SemicolonExpected/Brobot/README.txt

TTree goes into the library.

Thanks for reading.
