SemicolonExpected/Brobot/Brobot-Assem.pdf

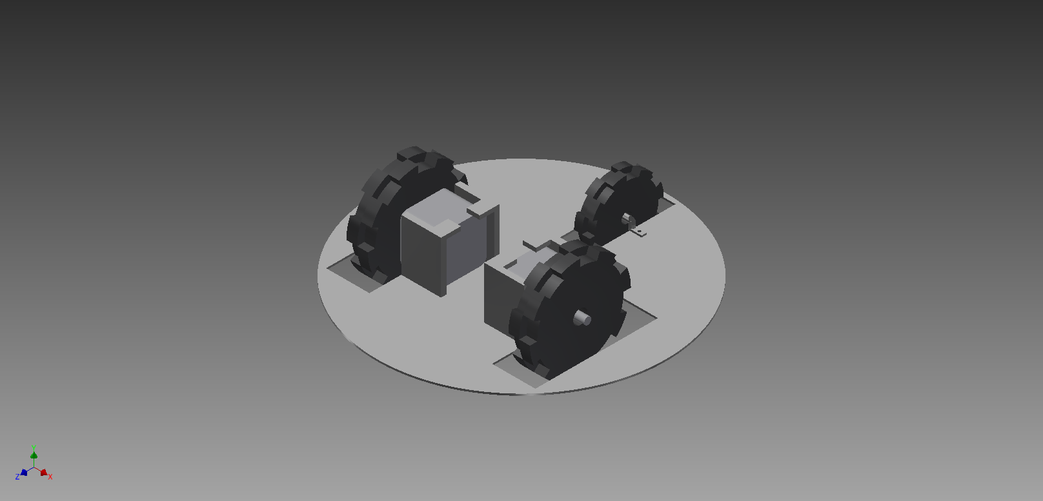
[picture p1: page 1]
