SemicolonExpected/Brobot/Brobot_schem.png

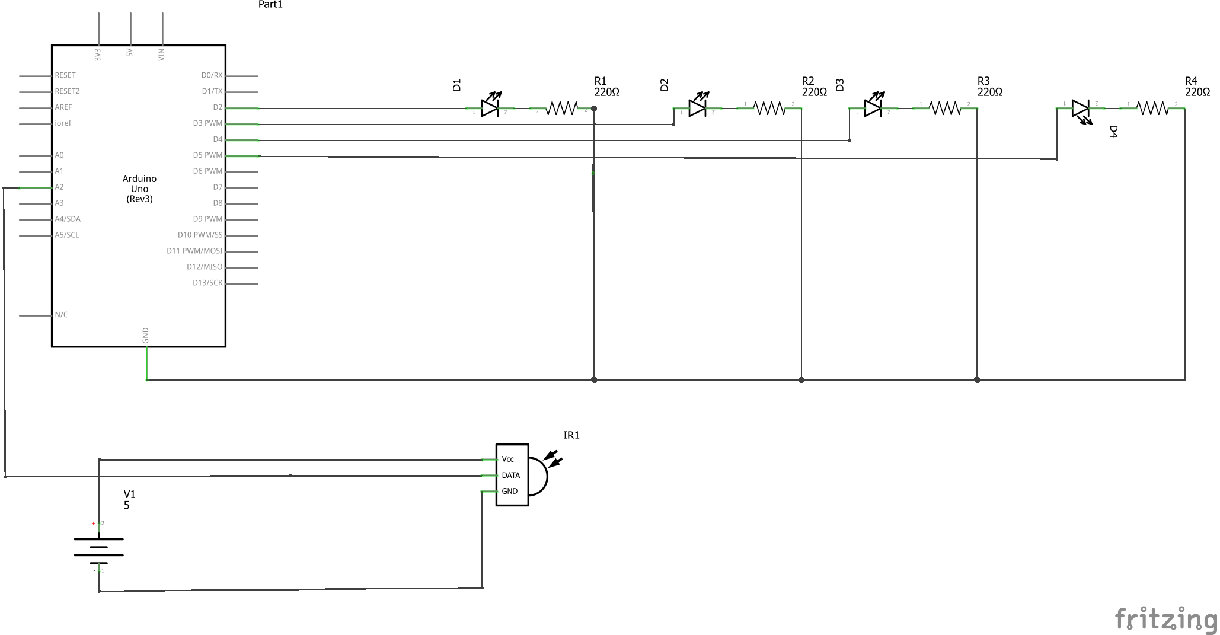
Brobot_schem.png
