SemicolonExpected/Brobot/WheelThing.pdf

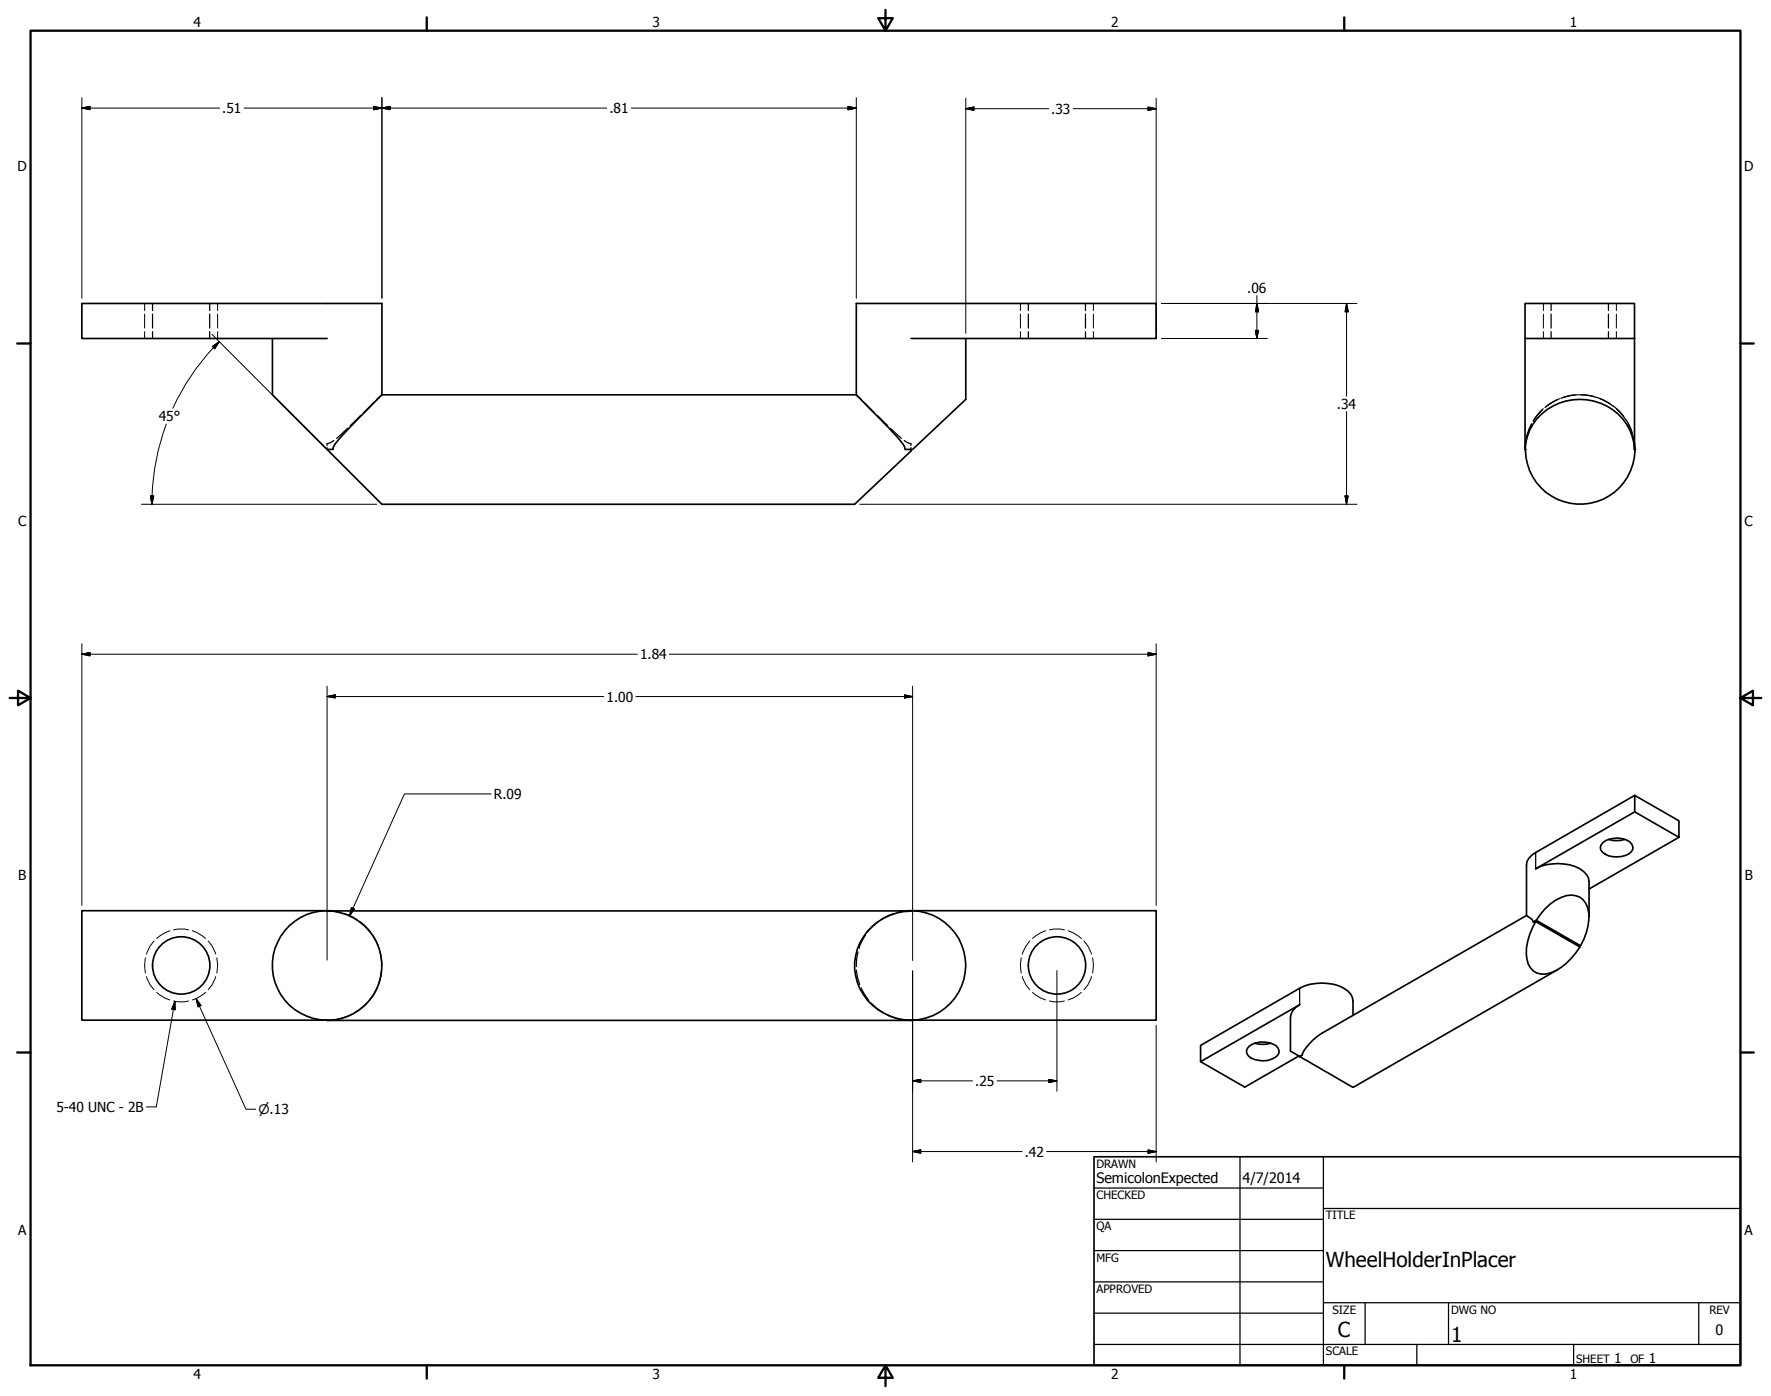
[picture p3: page 1]
SHEET 1 OF 1; DRAWN; CHECKED; MFG; APPROVED; SemicolonExpected; DWG NO 1; TITLE; WheelHolderInPlacer; SIZE C; SCALE; REV 0; 5-40 UNC - 2B
