SemicolonExpected/Brobot/Brobot.pdf

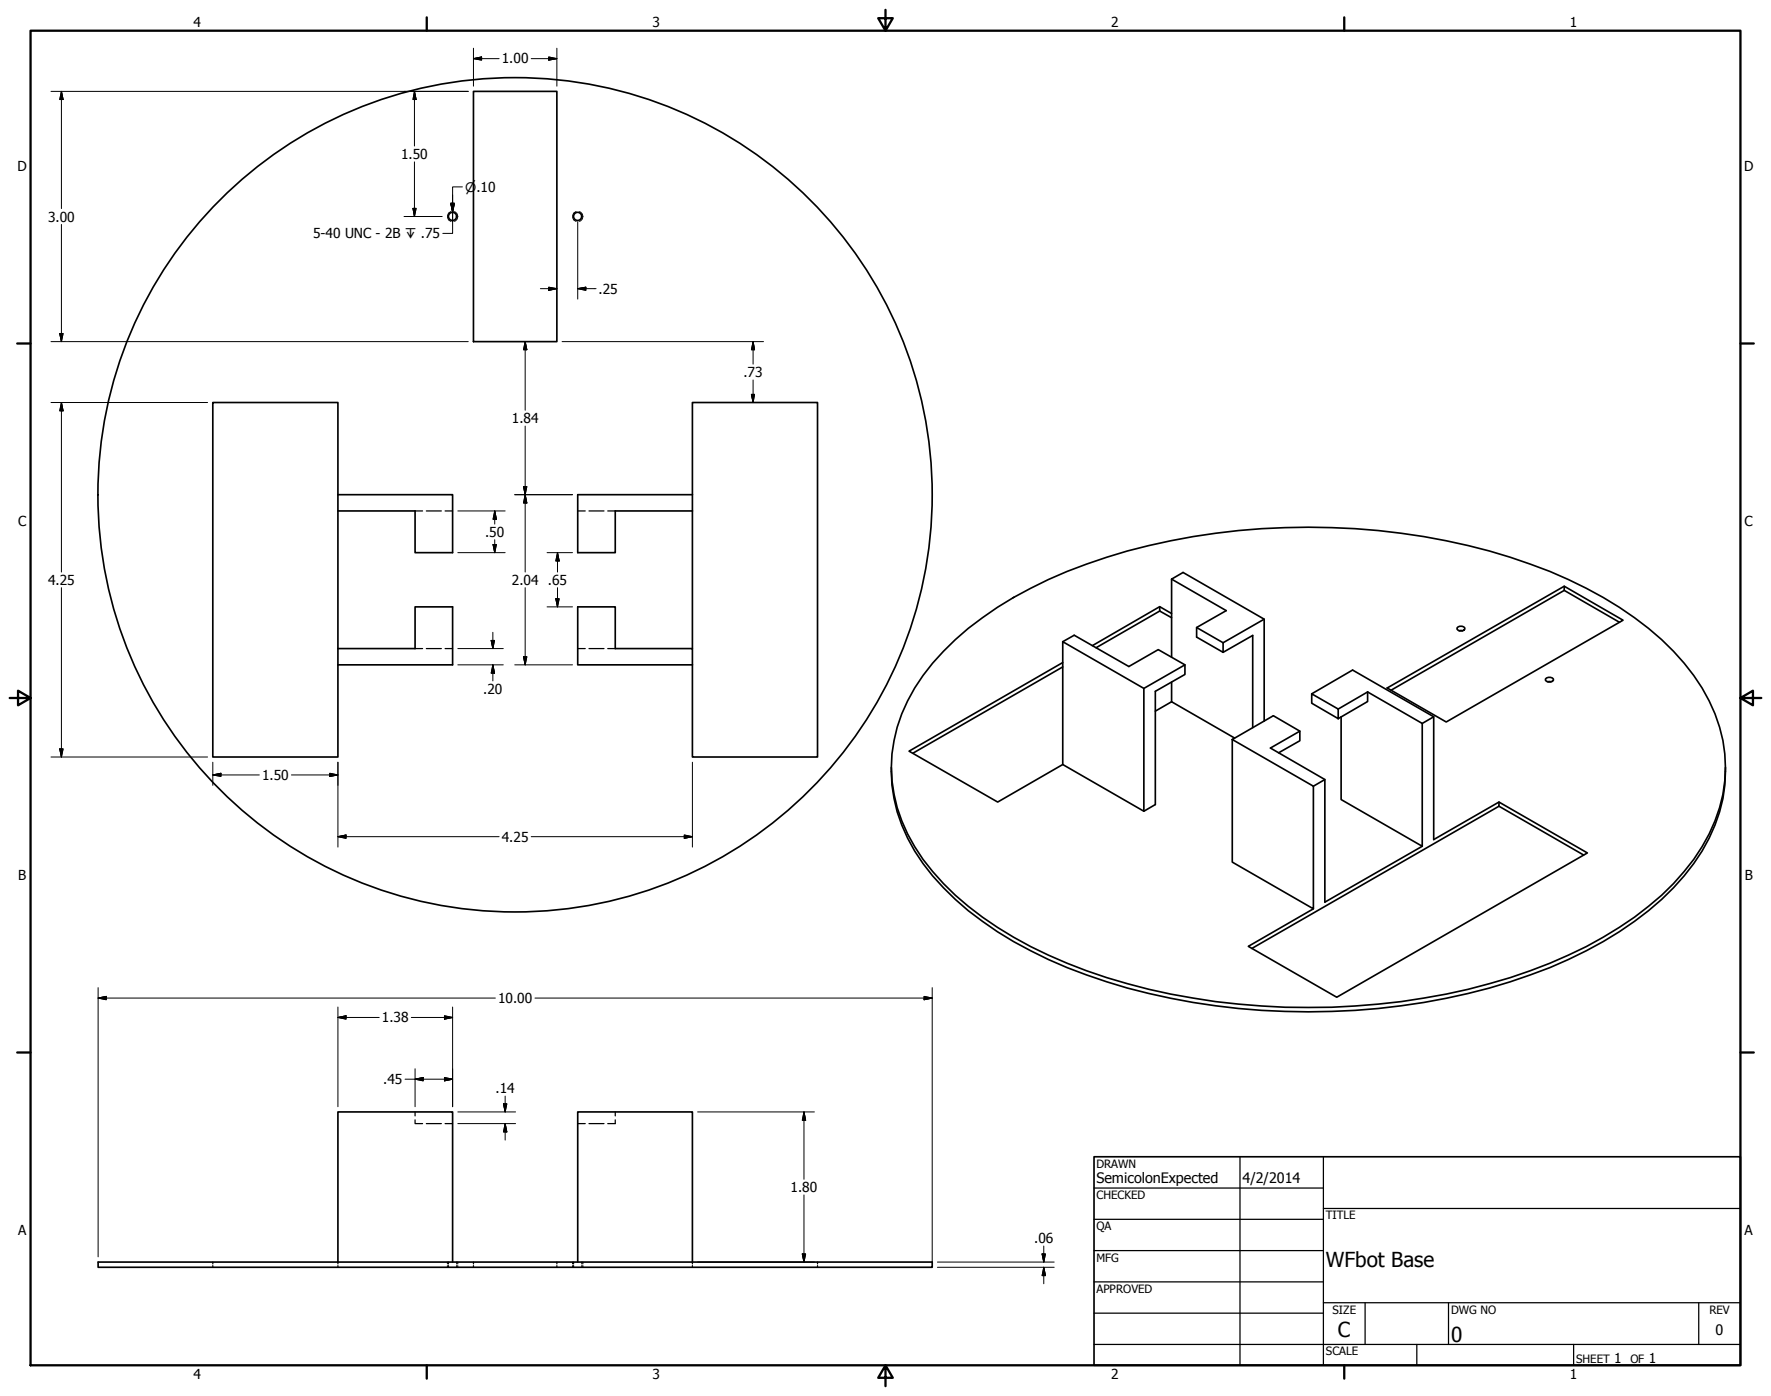
[picture p4: page 1]
SHEET 1 OF 1; DRAWN; CHECKED; MFG; APPROVED; SemicolonExpected; DWG NO 0; TITLE; WFbot Base; SIZE C; SCALE; REV 0; 5-40 UNC - 2B Z .75
